falthaus/mppt-esc/hw/MPPT-ESC Schematics v1.pdf

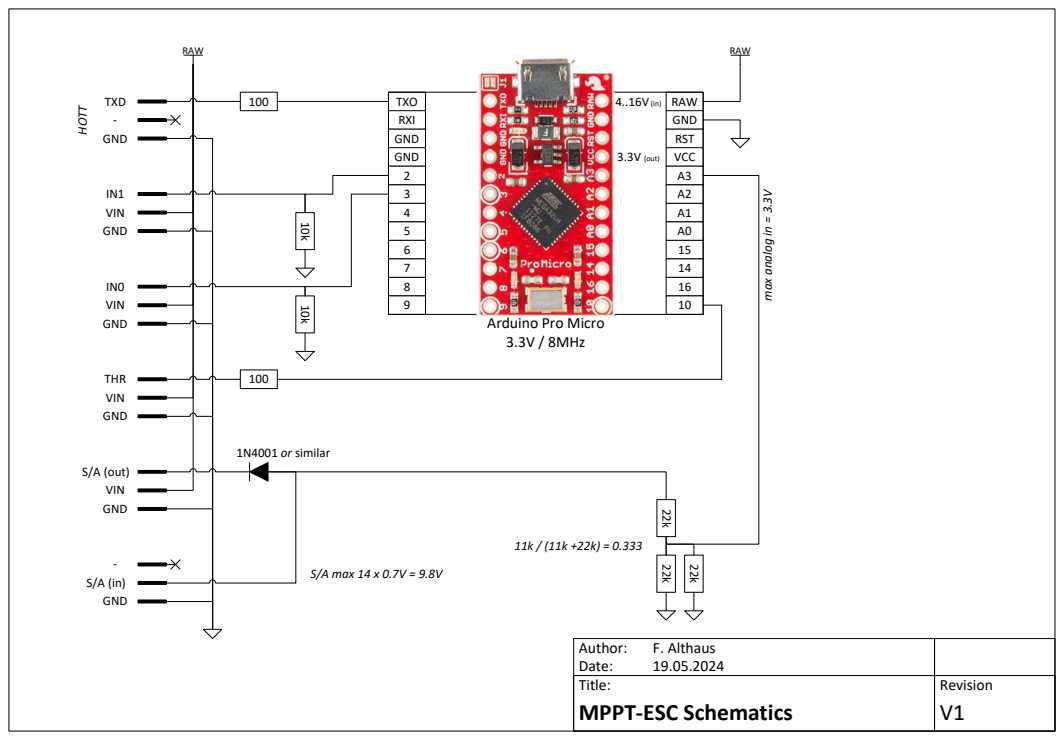
[picture p1: page 1]
Author: Date:; F. Althaus 19.05.2024; Revision; MPPT-ESC Schematics; Title:; TXO RXI GND GND 2 3 4 5 6 7 8 9; RAW GND RST VCC A3 A2 A1 A0 15 14 16 10; 3.3V (out); TXD; GND; VIN; THR; S/A (out); RAW; 100 HOTT; S/A max 14 x 0.7V = 9.8V; max analog in = 3.3V; 1N4001 or similar

Arduino Pro Micro
3.3V / 8MHz
