falthaus/mppt-esc/hw/MPPT-ESC Interfaces v1.pdf

Configuration with Battery + S/A | Configuration with S/A only UART TX (e.g. telemetry, for later)

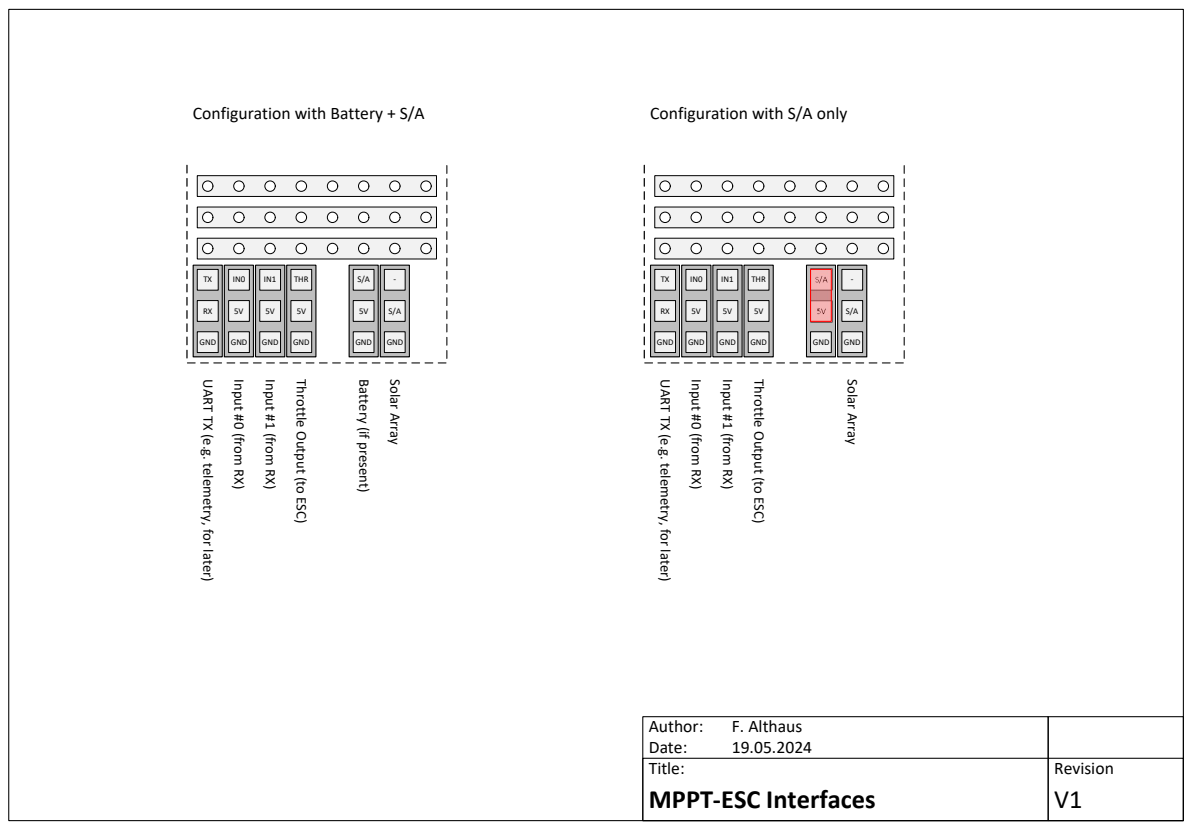
[picture p3: page 1]
TXRX GND; GND; THR; - UART TX (e.g. telemetry, for later); Input #0 (from RX); Input #1 (from RX); Throttle Output (to ESC); Battery (if present); Solar Array; - Input #0 (from RX)

Author: F. Althaus Date: 19.05.2024

Title: MPPT-ESC Interfaces | Revision V1
