falthaus/mppt-esc/hw/Arduino Pro Micro v13b Schematics.pdf

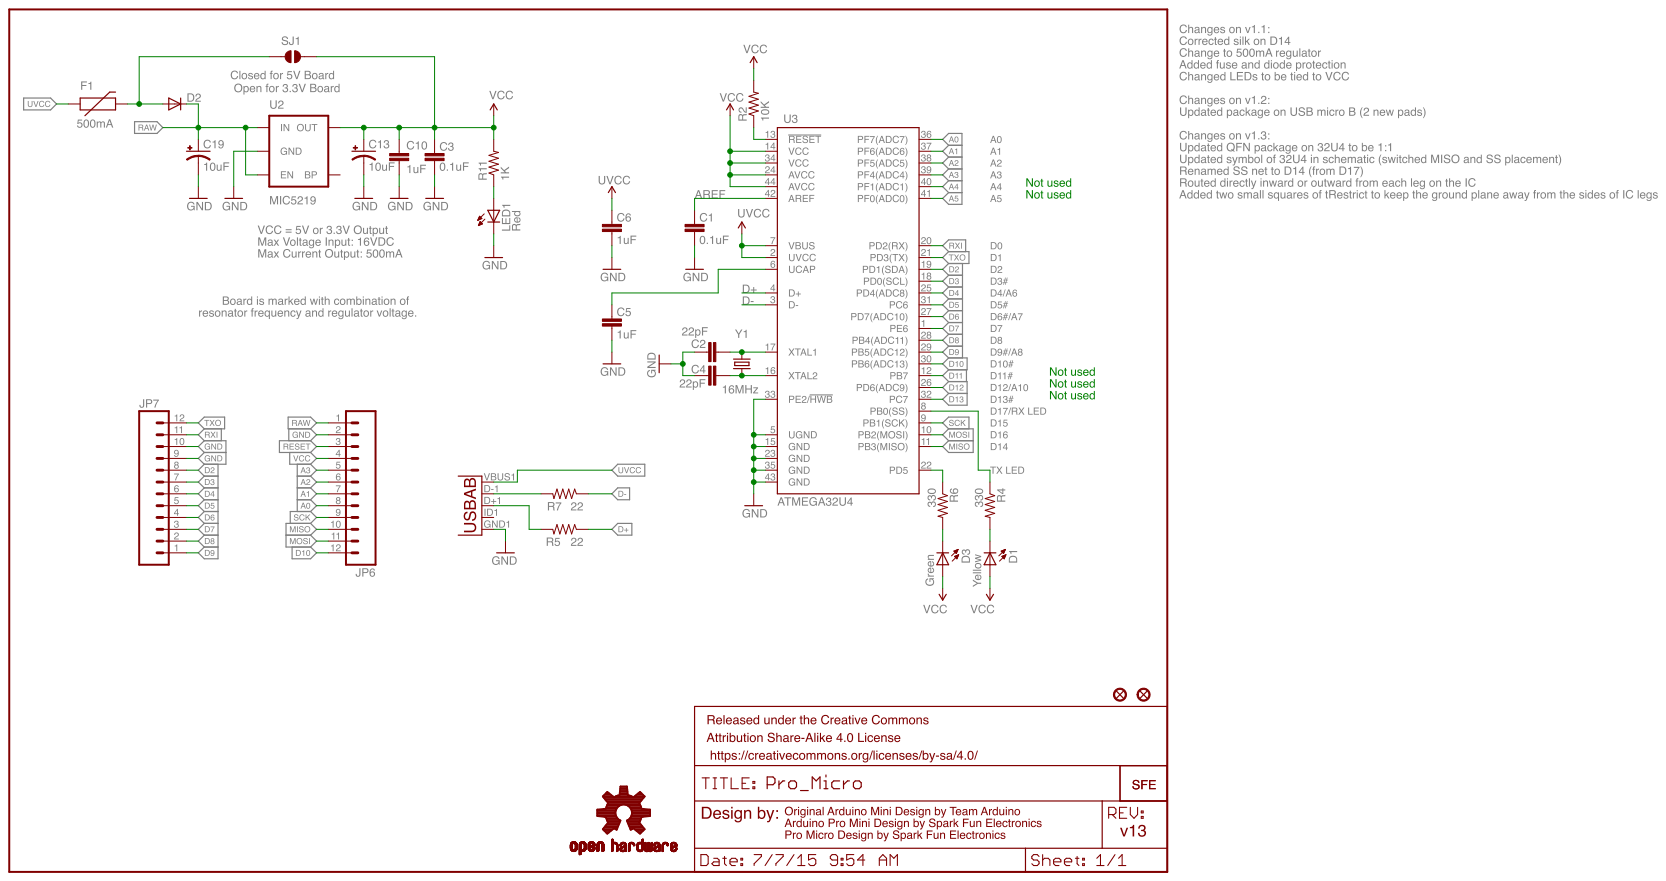
[picture p4: page 1]
